JStrebeyko/ouija/mega/mega.ino

#include <AccelStepper.h>
#include <EEPROM.h>

#define RST_PIN 6

#define dirPin 8    // pins for xl motor
#define stepPin 9   // pins for xl motor
#define dir2Pin 10  // pins for xr motor
#define step2Pin 11 // pins for xr motor
#define dir3Pin 12  // pins for y motor
#define step3Pin 13 // pins for y motor
#define motorInterfaceType 1

// Define a stepper and the pins it will use
AccelStepper xl = AccelStepper(motorInterfaceType, stepPin, dirPin);
AccelStepper xr = AccelStepper(motorInterfaceType, step2Pin, dir2Pin);
AccelStepper y = AccelStepper(motorInterfaceType, step3Pin, dir3Pin);

boolean isStopped = false;

// set contactrons pins
int kontXtPin = 2;
int kontXbPin = 3;
int kontYlPin = 4;
int kontYrPin = 5;

// stepper settings
long steps = 10000; // default 5000
long width = 0;
long height = 0;
bool calibratedX = false;
bool calibratedY = false;

// letter positioning variables
float t = 0;
long r = 0; // radius
long xPos = 0;
long yPos = 0;

// declare speed
float gSpeed = 10000.0;

// Define structures for character positions
struct Position
{
  int x; // X coordinate (0-50)
  int y; // Y coordinate (0-50)
};

#define NUM_LETTERS 26
#define NUM_NUMBERS 10
#define NUM_SPECIAL_CHARS 16  // Common special characters

// Arrays to store x,y positions for each character
Position letterPositions[NUM_LETTERS];    // A-Z
Position numberPositions[NUM_NUMBERS];    // 0-9
Position specialCharPositions[NUM_SPECIAL_CHARS]; // Special characters

// Special characters we support
const char SPECIAL_CHARS[NUM_SPECIAL_CHARS] = {
  '!', '@', '#', '$', '%', '^', '&', '*', '(', ')', '-', '_', '+', '=', ',', '/'
};

// EEPROM addresses
#define EEPROM_INITIALIZED_FLAG 0  // Address 0: Flag to check if EEPROM has been initialized
#define EEPROM_LETTERS_START 1     // Starting address for letter positions
#define EEPROM_NUMBERS_START 105   // Starting address for number positions (1 + 26*4)
#define EEPROM_SPECIAL_START 145   // Starting address for special characters (105 + 10*4)

// Helper function to get index of a special character
int getSpecialCharIndex(char c) {
  for (int i = 0; i < NUM_SPECIAL_CHARS; i++) {
    if (SPECIAL_CHARS[i] == c) {
      return i;
    }
  }
  return -1; // Not found
}

// Get position information for a specific character
bool getCharPosition(char c, Position& pos) {
  if (isAlpha(c)) {
    int index = toupper(c) - 'A';
    if (index >= 0 && index < NUM_LETTERS) {
      pos = letterPositions[index];
      return true;
    }
  } 
  else if (isDigit(c)) {
    int index = c - '0';
    if (index >= 0 && index < NUM_NUMBERS) {
      pos = numberPositions[index];
      return true;
    }
  }
  else {
    int index = getSpecialCharIndex(c);
    if (index >= 0) {
      pos = specialCharPositions[index];
      return true;
    }
  }
  return false;
}

// Initialize default positions in a circle
void initializeDefaultPositions()
{
  // Calculate default positions for letters (larger circle)
  for (int i = 0; i < NUM_LETTERS; i++)
  {
    float angle = -((6.28319 / NUM_LETTERS) * i);
    // Convert from polar to cartesian coordinates and map to 0-50 range
    letterPositions[i].x = 25 + round(20 * cos(angle));
    letterPositions[i].y = 25 + round(20 * sin(angle));
  }

  // Calculate default positions for numbers (smaller circle)
  for (int i = 0; i < NUM_NUMBERS; i++)
  {
    float angle = -((6.28319 / NUM_NUMBERS) * i);
    // Use smaller radius for numbers
    numberPositions[i].x = 25 + round(15 * cos(angle));
    numberPositions[i].y = 25 + round(15 * sin(angle));
  }
  
  // Calculate default positions for special characters (smallest circle)
  for (int i = 0; i < NUM_SPECIAL_CHARS; i++)
  {
    float angle = -((6.28319 / NUM_SPECIAL_CHARS) * i);
    // Use smallest radius for special characters
    specialCharPositions[i].x = 25 + round(10 * cos(angle));
    specialCharPositions[i].y = 25 + round(10 * sin(angle));
  }
}

// Save all positions to EEPROM
void savePositionsToEEPROM()
{
  // Write initialized flag
  EEPROM.write(EEPROM_INITIALIZED_FLAG, 42); // Use 42 as our initialized flag
  
  // Save letter positions
  int addr = EEPROM_LETTERS_START;
  for (int i = 0; i < NUM_LETTERS; i++)
  {
    EEPROM.write(addr++, letterPositions[i].x);
    EEPROM.write(addr++, letterPositions[i].y);
  }
  
  // Save number positions
  addr = EEPROM_NUMBERS_START;
  for (int i = 0; i < NUM_NUMBERS; i++)
  {
    EEPROM.write(addr++, numberPositions[i].x);
    EEPROM.write(addr++, numberPositions[i].y);
  }
  
  // Save special character positions
  addr = EEPROM_SPECIAL_START;
  for (int i = 0; i < NUM_SPECIAL_CHARS; i++)
  {
    EEPROM.write(addr++, specialCharPositions[i].x);
    EEPROM.write(addr++, specialCharPositions[i].y);
  }
  
  Serial1.println("Positions saved to EEPROM");
}

// Load all positions from EEPROM
bool loadPositionsFromEEPROM()
{
  // Check if EEPROM has been initialized
  byte initialized = EEPROM.read(EEPROM_INITIALIZED_FLAG);
  if (initialized != 42) // If not our magic number
  {
    Serial1.println("EEPROM not initialized, using default positions");
    return false;
  }
  
  // Load letter positions
  int addr = EEPROM_LETTERS_START;
  for (int i = 0; i < NUM_LETTERS; i++)
  {
    letterPositions[i].x = EEPROM.read(addr++);
    letterPositions[i].y = EEPROM.read(addr++);
  }
  
  // Load number positions
  addr = EEPROM_NUMBERS_START;
  for (int i = 0; i < NUM_NUMBERS; i++)
  {
    numberPositions[i].x = EEPROM.read(addr++);
    numberPositions[i].y = EEPROM.read(addr++);
  }
  
  // Load special character positions
  addr = EEPROM_SPECIAL_START;
  for (int i = 0; i < NUM_SPECIAL_CHARS; i++)
  {
    specialCharPositions[i].x = EEPROM.read(addr++);
    specialCharPositions[i].y = EEPROM.read(addr++);
  }
  
  Serial1.println("Positions loaded from EEPROM");
  return true;
}

// Save a specific character position to EEPROM
void saveCharPositionToEEPROM(char targetChar)
{
  int addr;
  int index;
  
  if (isAlpha(targetChar))
  {
    index = toupper(targetChar) - 'A';
    if (index >= 0 && index < NUM_LETTERS)
    {
      addr = EEPROM_LETTERS_START + (index * 2);
      EEPROM.write(addr, letterPositions[index].x);
      EEPROM.write(addr + 1, letterPositions[index].y);
      Serial1.print("Position for '");
      Serial1.print(targetChar);
      Serial1.println("' saved to EEPROM");
    }
  }
  else if (isDigit(targetChar))
  {
    index = targetChar - '0';
    if (index >= 0 && index < NUM_NUMBERS)
    {
      addr = EEPROM_NUMBERS_START + (index * 2);
      EEPROM.write(addr, numberPositions[index].x);
      EEPROM.write(addr + 1, numberPositions[index].y);
      Serial1.print("Position for '");
      Serial1.print(targetChar);
      Serial1.println("' saved to EEPROM");
    }
  }
  else
  {
    // Check if it's a special character
    index = getSpecialCharIndex(targetChar);
    if (index >= 0)
    {
      addr = EEPROM_SPECIAL_START + (index * 2);
      EEPROM.write(addr, specialCharPositions[index].x);
      EEPROM.write(addr + 1, specialCharPositions[index].y);
      Serial1.print("Position for '");
      Serial1.print(targetChar);
      Serial1.println("' saved to EEPROM");
    }
  }
  
  // Make sure the initialized flag is set
  EEPROM.write(EEPROM_INITIALIZED_FLAG, 42);
}

// --- Debounce helper ---
// Returns true only if the pin reads LOW for `confirmations` consecutive reads.
// 200us between reads is long enough to outlast inductive glitches from stepper drivers
// but short enough not to affect motor motion at calibration speed.
// Increase confirmations (e.g. to 5 or 10) if false triggers persist.
bool isTriggered(int pin, uint8_t confirmations = 3) {
  for (uint8_t i = 0; i < confirmations; i++) {
    if (digitalRead(pin) == HIGH) return false;
    delayMicroseconds(200);
  }
  return true;
}

// declare functions
void runSpeedX()
{
  xl.runSpeed();
  xr.runSpeed();
}

void runSpeedToPositionX()
{
  xl.runSpeedToPosition();
  xr.runSpeedToPosition();
}

void moveToX(long x)
{
  xl.moveTo(x);
  xr.moveTo(x);
}

void stopX()
{
  xl.stop();
  xr.stop();
}

void moveX(long st)
{
  xl.move(st);
  xr.move(st);
}

void setCurrentPositionX(long pos)
{
  xl.setCurrentPosition(pos);
  xr.setCurrentPosition(pos);
}

void steppersSetup(float maxSpeed, float speed, float accel)
{
  xl.setMaxSpeed(maxSpeed);
  xl.setSpeed(speed);
  xl.setAcceleration(accel);

  xr.setMaxSpeed(maxSpeed);
  xr.setSpeed(speed);
  xr.setAcceleration(accel);

  y.setMaxSpeed(maxSpeed);
  y.setSpeed(speed);
  y.setAcceleration(accel);
}

bool calibrateX()
{
  int direction = 1;
  bool done = false;
  Serial1.println("calibrating x...");
  while (!calibratedX)
  {
    if (!done)
    {
      // isTriggered() requires 3 consecutive LOW reads to confirm,
      // filtering out single-sample noise spikes from the stepper drivers.
      bool kontaktXt = isTriggered(kontXtPin);
      bool kontaktXb = isTriggered(kontXbPin);
      if (direction == 1)
      {
        if (!kontaktXt)
        {
          moveX(steps);
        }
        else
        {
          setCurrentPositionX(0);
          direction = 0;
        }
      }
      else
      {
        if (!kontaktXb)
        {
          moveX(-steps);
        }
        else
        {
          stopX();
          width = xl.currentPosition();
          delay(1000);
          done = true;
          moveToX(width / 2);
        }
      }
      runSpeedX();
    }
    else
    {
      runSpeedToPositionX();
      if (xl.distanceToGo() == 0)
      {
        calibratedX = true;
        Serial1.println("X calibrated");
      }
    }
  }
}

bool calibrateY()
{
  bool done = false;
  Serial1.println("calibrating y...");
  int direction = 0;
  while (!calibratedY)
  {
    if (!done)
    {
      // isTriggered() requires 3 consecutive LOW reads to confirm,
      // filtering out single-sample noise spikes from the stepper drivers.
      bool kontaktYl = isTriggered(kontYlPin);
      bool kontaktYr = isTriggered(kontYrPin);

      if (direction == 0)
      {
        if (!kontaktYl)
        {
          y.move(steps);
        }
        else
        {
          y.setCurrentPosition(0);
          direction = 1;
        }
      }
      else
      {
        if (!kontaktYr)
        {
          y.move(-steps);
        }
        else
        {
          y.stop();
          height = y.currentPosition();
          delay(1000);
          done = true;
          y.moveTo(height / 2);
          continue;
        }
      }
      y.runSpeed();
    }
    else
    {
      y.runSpeedToPosition();
      if (y.distanceToGo() == 0)
      {
        calibratedY = true;
        Serial1.println("Y calibrated");
        return true;
      }
    }
  }
}

void charPos(char letter = 'a')
{
  if (letter == ' ' || letter == '.')
  {
    // Center position
    xPos = width / 2;
    yPos = height / 2;
    return;
  }

  Position pos;
  if (isAlpha(letter))
  {
    int index = toupper(letter) - 'A';
    if (index >= 0 && index < NUM_LETTERS)
    {
      pos = letterPositions[index];
    }
  }
  else if (isDigit(letter))
  {
    int index = letter - '0';
    if (index >= 0 && index < NUM_NUMBERS)
    {
      pos = numberPositions[index];
    }
  }
  else
  {
    // Check if it's a special character
    int index = getSpecialCharIndex(letter);
    if (index >= 0)
    {
      pos = specialCharPositions[index];
    }
    else
    {
      // Default to center if character not found
      xPos = width / 2;
      yPos = height / 2;
      return;
    }
  }

  // Map the 0-50 position to actual width/height
  xPos = map(pos.x, 0, 50, 0, width);
  yPos = map(pos.y, 0, 50, 0, height);
}

void playString(String sentence = " ")
{
  int kontaktYl = digitalRead(kontYlPin);
  int kontaktYr = digitalRead(kontYrPin);
  int kontaktXt = digitalRead(kontXtPin);
  int kontaktXb = digitalRead(kontXbPin);

  if (xl.distanceToGo() == 0 && y.distanceToGo() == 0)
  {
    for (int i = 0; i <= sentence.length();)
    {
      if (i == sentence.length() && xl.distanceToGo() == 0 && y.distanceToGo() == 0)
      {
        Serial1.println("done displaying");
        break;
      }

      if (xl.distanceToGo() == 0 && y.distanceToGo() == 0)
      {
        charPos(sentence.charAt(i));
        delay(2000);
        moveToX(xPos);
        y.moveTo(yPos);
        i++;
      }

      if (kontaktYl == 0 || kontaktYr == 0 || kontaktXt == 0 || kontaktXb == 0)
      {
        Serial1.println("WARNING! End of area - going to next letter (please change this letter position or recalibrate)");
        charPos(sentence.charAt(i));
        moveToX(xPos);
        y.moveTo(yPos);
        i++;
      }

      if (Serial1.available())
      {
        String message = Serial1.readString();
        message.trim();
        if (message == String("STOP"))
        {
          Serial1.println("STOPPING");
          moveToX(xl.currentPosition());
          y.moveTo(y.currentPosition());
          runSpeedToPositionX();
          y.runSpeedToPosition();
          return;
        }
        
      }

      runSpeedToPositionX();
      y.runSpeedToPosition();
    }
  }
}

void calibrate()
{
  Serial1.println("calibrating...");
  steppersSetup(15000.0/4, 10000.0/4, 100000.0/4);

  moveToX(steps);
  calibratedX = false;
  calibratedY = false;
  calibrateX();
  calibrateY();
}

// Command handlers
void handleDisplay(String params)
{
  if (params.length() == 0)
  {
    Serial1.println("ERROR: nothing to display");
    return;
  }
  Serial1.println("OK");
  Serial1.print("Displaying: ");
  Serial1.println(params);
  playString(params);
}

void handleHome()
{
  Serial1.println("OK");
  Serial1.println("Homing sequence initiated");
  playString(" ");
}

void handleMove(String params)
{
  int spaceIndex = params.indexOf(' ');
  if (spaceIndex == -1)
  {
    Serial1.println("ERROR: Invalid parameters");
    return;
  }
  String xString = params.substring(0, spaceIndex);
  String yString = params.substring(spaceIndex + 1);

  long xCoord = map(xString.toInt(), 0, 50, 0, width);
  long yCoord = map(yString.toInt(), 0, 50, 0, height);

  Serial1.println("OK");
  Serial1.print("Moving to X: ");
  Serial1.print(xCoord);
  Serial1.print(", Y: ");
  Serial1.println(yCoord);

  moveToX(xCoord);
  y.moveTo(yCoord);

  while (xl.distanceToGo() != 0 || xr.distanceToGo() != 0 || y.distanceToGo() != 0)
  {
    if (Serial1.available())
    {
      String message = Serial1.readString();
      message.trim();
      if (message == String("STOP"))
      {
        Serial1.println("Movement stopped");
        return;
      }
    }
    runSpeedToPositionX();
    y.runSpeedToPosition();
  }

  Serial1.println("Done moving");
}

void handleSetSpeed(String params)
{
  float newSpeed = params.toFloat();
  if (newSpeed <= 0.0 || newSpeed > 100.0)
  {
    Serial1.println("ERROR: Invalid speed value. It must be between 0.0 and 100.0");
    return;
  }
  Serial1.println("OK");
  Serial1.print("Speed set to ");
  Serial1.println(newSpeed);

  gSpeed = map(newSpeed, 0, 100, 0, 15000);
  steppersSetup(15000.0, gSpeed, 100000.0);
}

void handleGetSpeed()
{
  Serial1.print("SPEED ");
  Serial1.println(map(gSpeed, 0, 15000, 0, 100));
}

void handleCharPos(String params)
{
  // Expected format: "CHARPOS [char] [x] [y]"
  int firstSpace = params.indexOf(' ');
  int secondSpace = params.indexOf(' ', firstSpace + 1);

  if (firstSpace == -1 || secondSpace == -1)
  {
    Serial1.println("ERROR: Invalid CHARPOS format. Use: CHARPOS [char] [x] [y]");
    return;
  }

  String charStr = params.substring(0, firstSpace);
  String xStr = params.substring(firstSpace + 1, secondSpace);
  String yStr = params.substring(secondSpace + 1);

  char targetChar = charStr.charAt(0);
  int newX = xStr.toInt();
  int newY = yStr.toInt();

  // Validate coordinates
  if (newX < 0 || newX > 50 || newY < 0 || newY > 50)
  {
    Serial1.println("ERROR: Coordinates must be between 0 and 50");
    return;
  }

  // Update the appropriate array and save to EEPROM
  if (isAlpha(targetChar))
  {
    int index = toupper(targetChar) - 'A';
    if (index >= 0 && index < NUM_LETTERS)
    {
      letterPositions[index].x = newX;
      letterPositions[index].y = newY;
      // Save to EEPROM
      saveCharPositionToEEPROM(targetChar);
      Serial1.print("OK: Updated position for '");
      Serial1.print(targetChar);
      Serial1.print("' to x=");
      Serial1.print(newX);
      Serial1.print(" y=");
      Serial1.println(newY);
    }
    else
    {
      Serial1.println("ERROR: Invalid letter");
    }
  }
  else if (isDigit(targetChar))
  {
    int index = targetChar - '0';
    if (index >= 0 && index < NUM_NUMBERS)
    {
      numberPositions[index].x = newX;
      numberPositions[index].y = newY;
      // Save to EEPROM
      saveCharPositionToEEPROM(targetChar);
      Serial1.print("OK: Updated position for '");
      Serial1.print(targetChar);
      Serial1.print("' to x=");
      Serial1.print(newX);
      Serial1.print(" y=");
      Serial1.println(newY);
    }
    else
    {
      Serial1.println("ERROR: Invalid number");
    }
  }
  else
  {
    // Check if it's a special character
    int index = getSpecialCharIndex(targetChar);
    if (index >= 0)
    {
      specialCharPositions[index].x = newX;
      specialCharPositions[index].y = newY;
      // Save to EEPROM
      saveCharPositionToEEPROM(targetChar);
      Serial1.print("OK: Updated position for '");
      Serial1.print(targetChar);
      Serial1.print("' to x=");
      Serial1.print(newX);
      Serial1.print(" y=");
      Serial1.println(newY);
    }
    else
    {
      Serial1.println("ERROR: Character not supported");
    }
  }
}

void handleCalibrate()
{
  Serial1.println("OK");
  Serial1.println("Calibration started");
  calibrate();
}

void handleEcho(String params)
{
  Serial1.print("ECHO ");
  Serial1.println(params);
}

void handleVersion()
{
  Serial1.println("VERSION 0.9.5 08.04.2025");
}

// Handle getting character positions for specific characters
void handleGetChar(String params)
{
  if (params.length() == 0) {
    // If no parameters, list all supported character types
    Serial1.println("Usage: GET_CHAR [char1] [char2] ...");
    Serial1.println("Supported character types: A-Z, 0-9, and special characters");
    Serial1.print("Supported special characters: ");
    for (int i = 0; i < NUM_SPECIAL_CHARS; i++) {
      Serial1.print(SPECIAL_CHARS[i]);
      Serial1.print(" ");
    }
    Serial1.println();
    return;
  }
  
  // Process each character in the parameters
  int currentPos = 0;
  while (currentPos < params.length()) {
    // Skip spaces
    while (currentPos < params.length() && params.charAt(currentPos) == ' ') {
      currentPos++;
    }
    
    // If we reached the end, break
    if (currentPos >= params.length()) {
      break;
    }
    
    // Get the character
    char c = params.charAt(currentPos);
    currentPos++; // Move to next position
    
    // Get position for the character
    Position pos;
    if (getCharPosition(c, pos)) {
      Serial1.print(c);
      Serial1.print(": x=");
      Serial1.print(pos.x);
      Serial1.print(" y=");
      Serial1.println(pos.y);
    } else {
      Serial1.print("ERROR: Character '");
      Serial1.print(c);
      Serial1.println("' not supported");
    }
  }
}

// List all supported characters
void handleListChars()
{
  Serial1.println("Supported characters:");
  
  // List letters
  Serial1.print("Letters: ");
  for (int i = 0; i < NUM_LETTERS; i++) {
    Serial1.print((char)('A' + i));
    Serial1.print(" ");
  }
  Serial1.println();
  
  // List numbers
  Serial1.print("Numbers: ");
  for (int i = 0; i < NUM_NUMBERS; i++) {
    Serial1.print((char)('0' + i));
    Serial1.print(" ");
  }
  Serial1.println();
  
  // List special characters
  Serial1.print("Special: ");
  for (int i = 0; i < NUM_SPECIAL_CHARS; i++) {
    Serial1.print(SPECIAL_CHARS[i]);
    Serial1.print(" ");
  }
  Serial1.println();
}

void handleStop()
{
  Serial1.print("Stopping...");
  isStopped = true;
}

// New command handlers for EEPROM operations
void handleSaveChars()
{
  savePositionsToEEPROM();
  Serial1.println("OK: All character positions saved to EEPROM");
}

void handleResetChars()
{
  initializeDefaultPositions();
  savePositionsToEEPROM();
  Serial1.println("OK: All character positions reset to defaults and saved to EEPROM");
}

void setup()
{
  Serial1.begin(9600);

  pinMode(kontXtPin, INPUT_PULLUP);
  pinMode(kontXbPin, INPUT_PULLUP);
  pinMode(kontYlPin, INPUT_PULLUP);
  pinMode(kontYrPin, INPUT_PULLUP);

  // Try to load positions from EEPROM, if not available use defaults
  if (!loadPositionsFromEEPROM())
  {
    // Initialize default character positions
    initializeDefaultPositions();
    // Save defaults to EEPROM
    savePositionsToEEPROM();
  }
  
  // calibrate
  calibrate();
}

void loop()
{
  if (Serial1.available())
  {
    String message = Serial1.readString();
    message.trim();

    int delimiterIndex = message.indexOf(' ');
    String command = delimiterIndex == -1 ? message : message.substring(0, delimiterIndex);
    String argument = delimiterIndex == -1 ? "" : message.substring(delimiterIndex + 1);

    if (command == String("CHARPOS"))
    {
      handleCharPos(argument);
    }
    else if (command == String("DISPLAY"))
    {
      handleDisplay(argument);
    }
    else if (command == String("HOME"))
    {
      handleHome();
    }
    else if (command == String("MOVE"))
    {
      handleMove(argument);
    }
    else if (command == String("SET_SPEED"))
    {
      handleSetSpeed(argument);
    }
    else if (command == String("GET_SPEED"))
    {
      handleGetSpeed();
    }
    else if (command == String("CALIBRATE"))
    {
      handleCalibrate();
    }
    else if (command == String("ECHO"))
    {
      handleEcho(argument);
    }
    else if (command == String("VERSION"))
    {
      handleVersion();
    }
    else if (command == String("STOP"))
    {
      handleStop();
    }
    else if (command == String("GET_CHAR"))
    {
      handleGetChar(argument);
    }
    else if (command == String("LIST_CHARS"))
    {
      handleListChars();
    }
    else if (command == String("SAVE_CHARS"))
    {
      handleSaveChars();
    }
    else if (command == String("RESET_CHARS"))
    {
      handleResetChars();
    }
  }
}
