JStrebeyko/ouija/esp/esp.ino

#include <ESP8266WiFi.h>
#include <ESP8266WebServer.h>
#include <DNSServer.h>
#include <SoftwareSerial.h>

const char* softAP_ssid = "NodeMCU_Serial";     // The name of the WiFi network
const char* softAP_password = "serial1234";     // Password for the WiFi network

// Static IP Configuration
IPAddress staticIP(192, 168, 4, 10);     // Choose a specific IP address
IPAddress gateway(192, 168, 4, 1);       // Default gateway for soft AP
IPAddress subnet(255, 255, 255, 0);      // Subnet mask

// DNS server configuration
const byte DNS_PORT = 53;
DNSServer dnsServer;

SoftwareSerial mySerial(13, 12);
ESP8266WebServer server(80);
#define MAX_LOG_LENGTH 16384
String serialLog = "";

// Function to trim log if it gets too long
void trimLog() {
  if (serialLog.length() > MAX_LOG_LENGTH) {
    int newlinePos = serialLog.indexOf('\n', serialLog.length() - MAX_LOG_LENGTH);
    if (newlinePos != -1) {
      serialLog = serialLog.substring(newlinePos + 1);
    }
  }
}

const int LED_PIN = LED_BUILTIN;
unsigned long previousMillis = 0;
const long interval = 1000;
bool ledState = false;

void setup() {
  pinMode(LED_PIN, OUTPUT);
  digitalWrite(LED_PIN, HIGH);
  for (int i = 0; i < 5; i++) {
    digitalWrite(LED_PIN, LOW);
    delay(200);
    digitalWrite(LED_PIN, HIGH);
    delay(200);
  }
  
  Serial.begin(9600);
  mySerial.begin(9600);
  
  // Set up soft access point with static IP
  WiFi.mode(WIFI_AP);
  WiFi.softAPConfig(staticIP, gateway, subnet);
  WiFi.softAP(softAP_ssid, softAP_password);
  
  // Start DNS server
  // This will redirect all domain requests to the device's IP
  dnsServer.start(DNS_PORT, "*", staticIP);
  
  // Print out the IP address of the soft AP
  IPAddress myIP = WiFi.softAPIP();
  Serial.print("AP IP address: ");
  Serial.println(myIP);
  
  #ifdef _SS_MAX_RX_BUFF
    mySerial.setBufferSize(256);
  #endif
  
  server.on("/", handleRoot);
  server.on("/send", HTTP_POST, handleSend);
  server.on("/read", handleRead);
  server.on("/clear", HTTP_POST, handleClear);
  
  server.begin();
}

void loop() {
  dnsServer.processNextRequest();  // Process DNS requests
  server.handleClient();
  
  unsigned long currentMillis = millis();
  if (currentMillis - previousMillis >= interval) {
    previousMillis = currentMillis;
    ledState = !ledState;
    digitalWrite(LED_PIN, ledState);
  }
}

void handleRoot() {
  server.send(200, "text/html", 
    "<!DOCTYPE html>"
    "<html>"
    "<head>"
    "<style>"
    "body {"
    "  display: flex;"
    "  justify-content: center;"
    "  align-items: center;"
    "  flex-direction: column;"
    "  font-family: Arial, sans-serif;"
    "  max-width: 600px;"
    "  margin: 0 auto;"
    "  text-align: center;"
    "}"
    "form { margin: 20px 0; }"
    "#serialLog {"
    "  border: 1px solid #ccc;"
    "  height: 300px;"
    "  overflow-y: scroll;"
    "  width: 100%;"
    "  text-align: left;"
    "  padding: 10px;"
    "  white-space: pre-line;"           // Changed to pre-line for better wrapping
    "  word-wrap: break-word;"           // For wrapping long words
    "  word-break: break-word;"          // Added for better wrapping behavior
    "  font-family: monospace;"          // Keep monospace font
    "  line-height: 1.4;"                // Keep line height
    "  max-width: 100%;"                 // Ensure content stays within container
    "}"
    ".button {"
    "  margin: 10px;"
    "  padding: 5px 15px;"
    "  cursor: pointer;"
    "}"
    "</style>"
    "</head>"
    "<body>"
    "<h1>Node MCU Serial Communication</h1>"
    "<form id=\"messageForm\">"
    "<input type=\"text\" id=\"messageInput\" placeholder=\"Enter message\">"
    "<input type=\"submit\" value=\"Send\">"
    "</form>"
    "<button onclick=\"clearSerialLog()\" class=\"button\">Clear Output</button>"
    "<div id=\"serialLog\"></div>"
    "<script>"
    "document.getElementById(\"messageForm\").addEventListener(\"submit\", function(e) {"
    "  e.preventDefault();"
    "  var message = document.getElementById(\"messageInput\").value;"
    "  fetch(\"/send\", {"
    "    method: \"POST\","
    "    body: new URLSearchParams({message: message}),"
    "    headers: {"
    "      \"Content-Type\": \"application/x-www-form-urlencoded\""
    "    }"
    "  });"
    "  document.getElementById(\"messageInput\").value = \"\";"
    "});"
    ""
    "function updateSerialData() {"
    "  fetch(\"/read\")"
    "    .then(response => response.text())"
    "    .then(data => {"
    "      document.getElementById(\"serialLog\").innerHTML = data;"
    "      const serialLog = document.getElementById(\"serialLog\");"
    "      serialLog.scrollTop = serialLog.scrollHeight;"    // Added this line
    "    });"
    "}"
    ""
    "function clearSerialLog() {"
    "  fetch(\"/clear\", {"
    "    method: \"POST\""
    "  }).then(() => {"
    "    document.getElementById(\"serialLog\").innerHTML = \"\";"
    "  });"
    "}"
    ""
    "setInterval(updateSerialData, 1000);"
    "</script>"
    "</body>"
    "</html>"
  );
}

void handleSend() {
  if (server.hasArg("message")) {
    String message = server.arg("message");
    mySerial.println(message);
    serialLog += "Sent: " + message + "\n";
    trimLog();    // Using single backslash for newline
    server.send(200, "text/plain", "Message sent");
  } else {
    server.send(400, "text/plain", "No message received");
  }
}

void handleRead() {
  String receivedMessage = "";
  while (mySerial.available()) {
    receivedMessage += mySerial.readStringUntil('\n');
  }
  if (receivedMessage.length() > 0) {
            serialLog += "Received: " + receivedMessage + "\n";
        trimLog();    // Using single backslash for newline
  }
  server.send(200, "text/html", serialLog);
}

void handleClear() {
  serialLog = "";
  server.send(200, "text/plain", "Log cleared");
}
