JStrebeyko/ouija/(commit log)

2024-03-05 two motors
2024-03-07 letters and numbers mapped, the board shows the string
2024-08-22 added the calibration switch
2025-04-07 corrected default letter positions so its not on the border
    [mega.ino]
2026-05-26 added debounce on kontaktrons + smaller accel in calibration so that motors dont stall
    [mega.ino]
2026-05-28 rewrote the README adn added wiring diagram
2026-05-28 little fix of the wiring image naming
2026-05-30 correcting the wiring diragram
